NeilL08/RLC-clock-PCB-design-Altium-/(list of files, drawings)

Other design files:
3032_battery_holder.PcbLib
3032_battery_holder.SchLib
RLC.SchDoc
RLC_PCB.PcbDoc
