NeilL08/RLC-clock-PCB-design-Altium-/(commit log)

2026-11-04 Revise README for ESP32 RTC Clock PCB project
    Updated project details and specifications for the ESP32 RTC Clock PCB, including status, overview, design decisions, pin map, bill of materials, design rules, bring-up plan, firmware plan, and repository layout.
2026-11-07 Update README with additional project visuals
    Added 3D render, schematic, and PCB layout images to README.
2026-11-07 Fix PCB layout image file names in README
    Updated image file names for PCB layouts in README.
2026-11-07 Add breadboard prototype section to README
    Added a section for the breadboard prototype with an image and description.
2026-11-07 Change breadboard prototype image to JPEG format
    Updated image file extension for breadboard prototype.
2026-11-08 Revise first prototype description in README
    Updated the description of the first prototype to clarify components and features.
2026-11-08 Add breadboarding firmware for I2S and OLED display
    This code initializes I2S, RTC, and OLED display, and displays the current time.
